udu3324/usb-mosaic_art/README.md

# usb-mosaic_art

A simple and fun gadget pcb
