udu3324/usb-mosaic_art/pcb/mosaic_usb/mosaic_usb.kicad_pcb

## KiCad design pcb/mosaic_usb/mosaic_usb.kicad_pcb (2026-08-22)

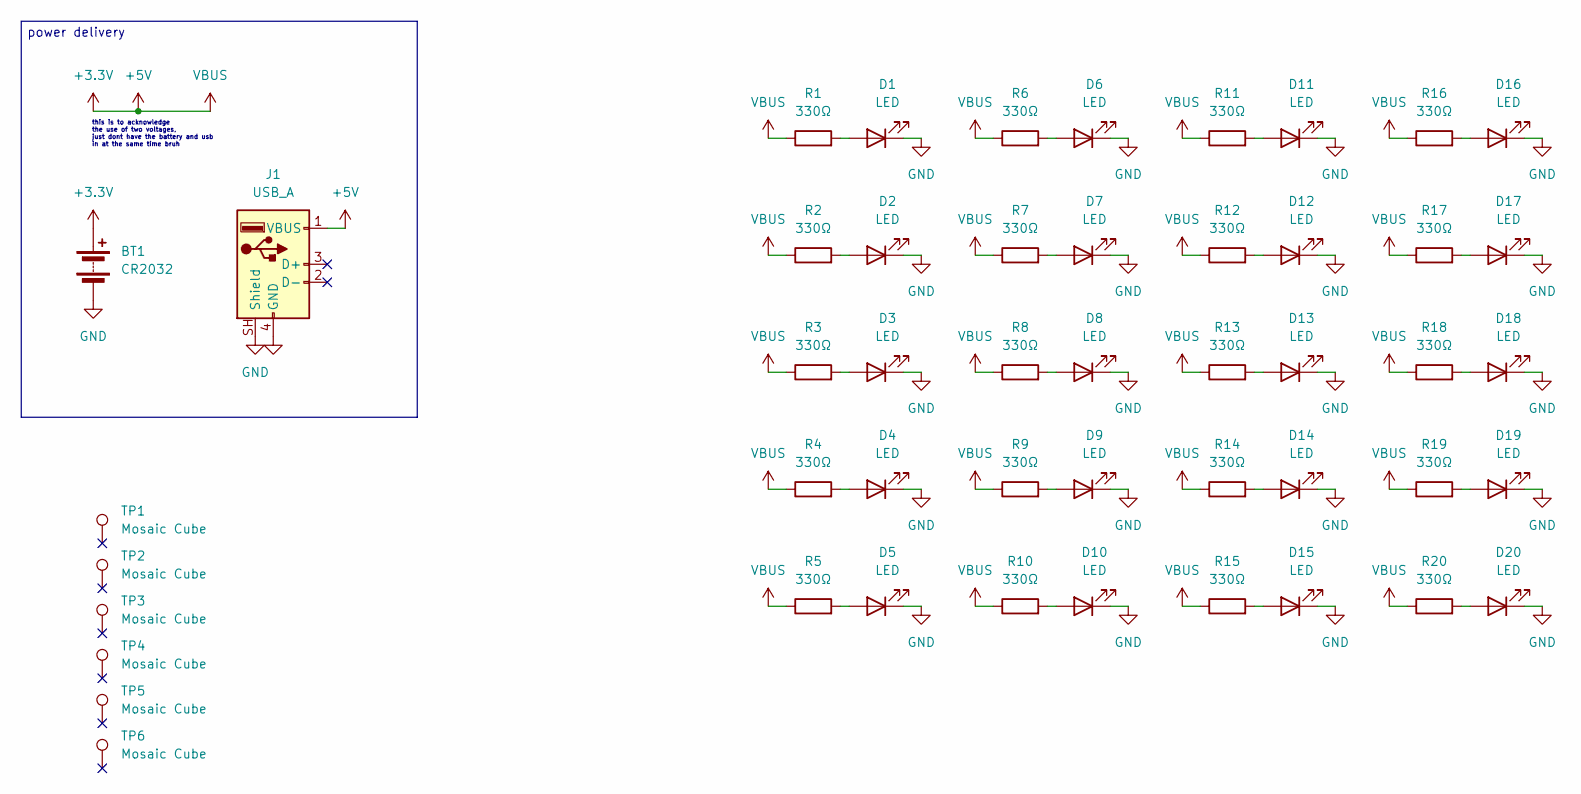
[picture p1: schematic mosaic_usb.kicad_sch]

Parts:
BT1: CR2032; BATT_HLDR_LNX
D1, D2, D3, D4, D5, D6, D7, D8, D9, D10, D11, D12, D13, D14, D15, D16, D17, D18, D19, D20: LED; LED_D3.0mm_Clear_Sideways_Hack
J1: USB_A; USB_A_PCB_Edge_receptacle
R1, R2, R3, R4, R5, R6, R7, R8, R9, R10, R11, R12, R13, R14, R15, R16, R17, R18, R19, R20: 330Ω; R_0603_1608Metric
TP1, TP2, TP3, TP4, TP5, TP6: Mosaic Cube; Mosaic Copper Cube

Connections:
+3.3V: BT1.1 (+), J1.1 (VBUS), R1.1, R2.1, R3.1, R4.1, R5.1, R6.1, R7.1, R8.1, R9.1, R10.1, R11.1, R12.1, R13.1, R14.1, R15.1, R16.1, R17.1, R18.1, R19.1, R20.1
GND: BT1.2 (-), D1.1 (K), D2.1 (K), D3.1 (K), D4.1 (K), D5.1 (K), D6.1 (K), D7.1 (K), D8.1 (K), D9.1 (K), D10.1 (K), D11.1 (K), D12.1 (K), D13.1 (K), D14.1 (K), D15.1 (K), D16.1 (K), D17.1 (K), D18.1 (K), D19.1 (K), D20.1 (K), J1.4 (GND), J1.SH (Shield)
unnamed: D1.2 (A), R1.2
unnamed: D2.2 (A), R2.2
unnamed: D3.2 (A), R3.2
unnamed: D4.2 (A), R4.2
unnamed: D5.2 (A), R5.2
unnamed: D6.2 (A), R6.2
unnamed: D7.2 (A), R7.2
unnamed: D8.2 (A), R8.2
unnamed: D9.2 (A), R9.2
unnamed: D10.2 (A), R10.2
unnamed: D11.2 (A), R11.2
unnamed: D12.2 (A), R12.2
unnamed: D13.2 (A), R13.2
unnamed: D14.2 (A), R14.2
unnamed: D15.2 (A), R15.2
unnamed: D16.2 (A), R16.2
unnamed: D17.2 (A), R17.2
unnamed: D18.2 (A), R18.2
unnamed: D19.2 (A), R19.2
unnamed: D20.2 (A), R20.2

Notes on the sheet:
this is to acknowledge the use of two voltages, just dont have the battery and usb in at the same time bruh
power delivery

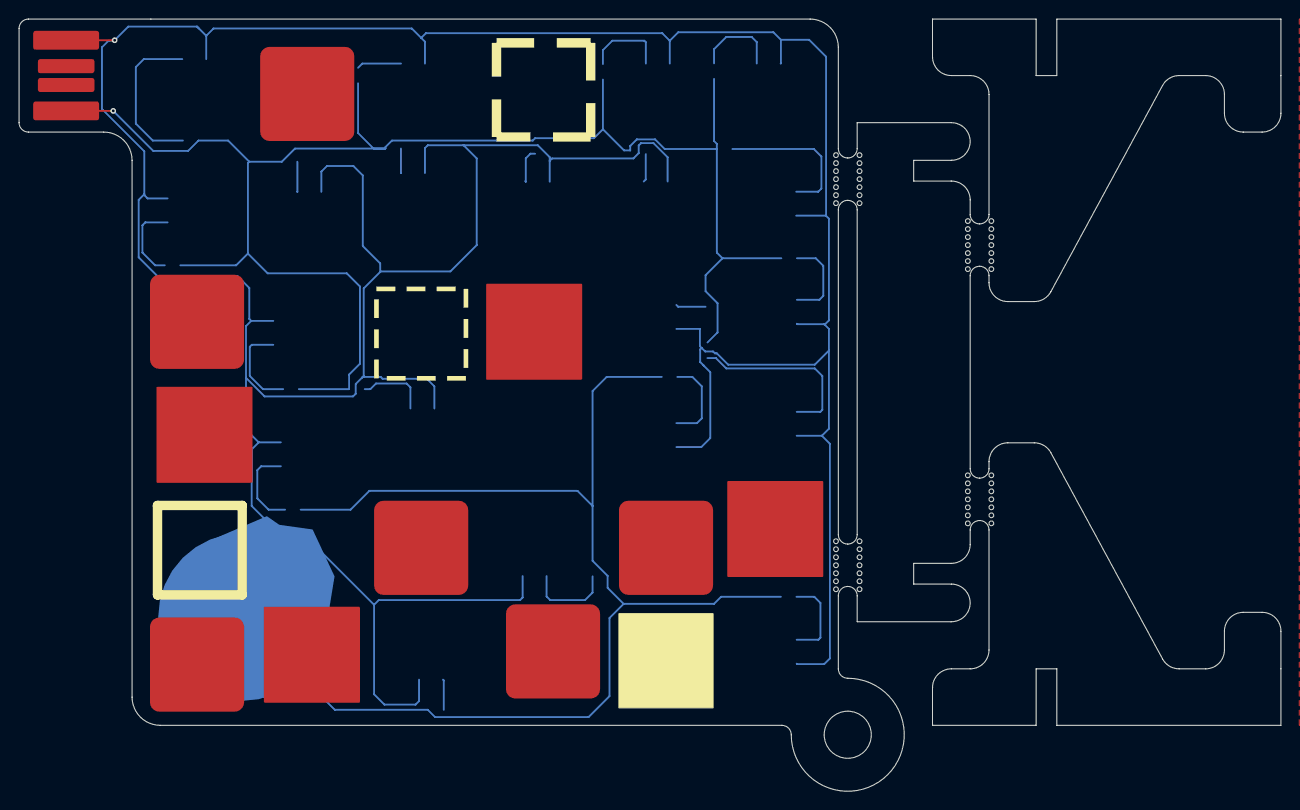
[picture p2: board mosaic_usb.kicad_pcb from above]

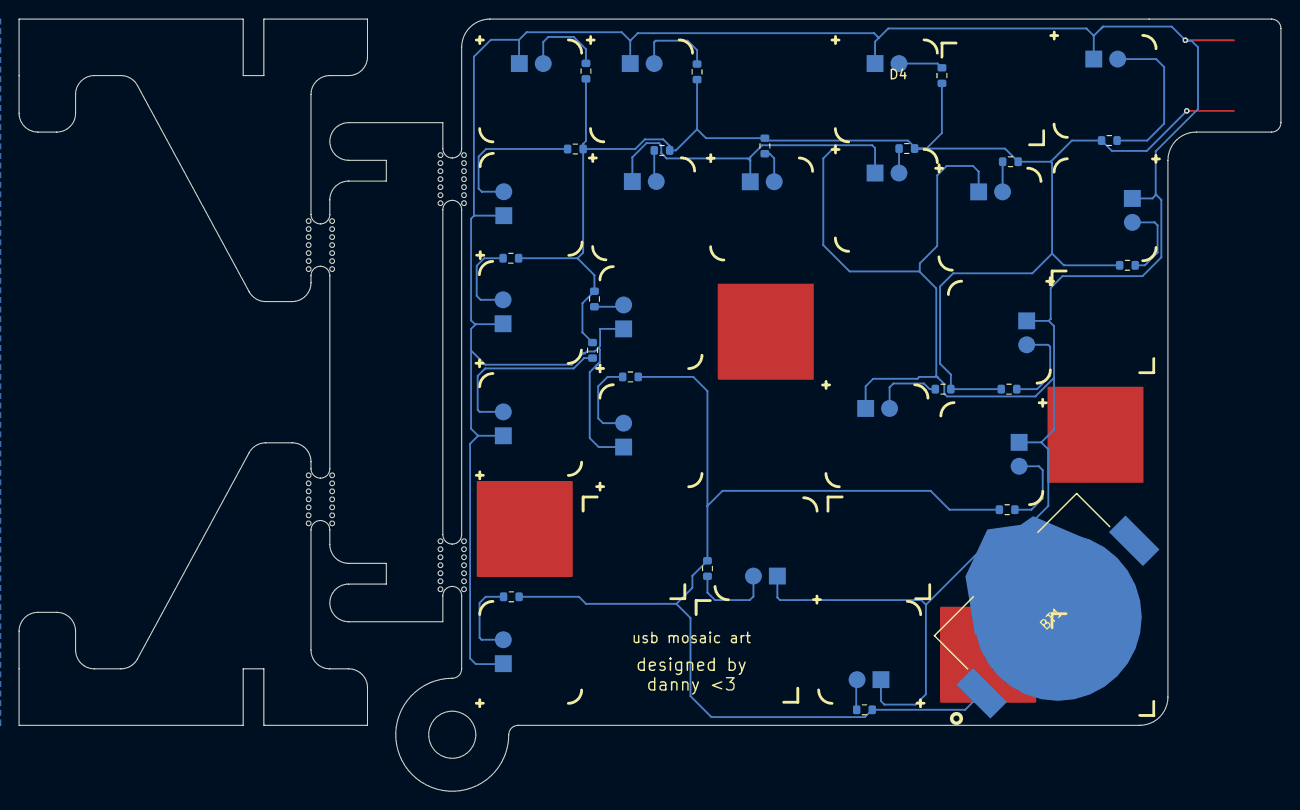
[picture p3: board mosaic_usb.kicad_pcb from below]

Board: 2 copper layers, 134.0 x 82.0 mm, 48 parts (41 on the bottom side), 22 nets.
