udu3324/usb-mosaic_art/JOURNAL.md

# Entry 1: The Sketch

8/12/2026 - 15-30 minutes (post git repo creation)

I started sketching out my project and what idea i had in mind.
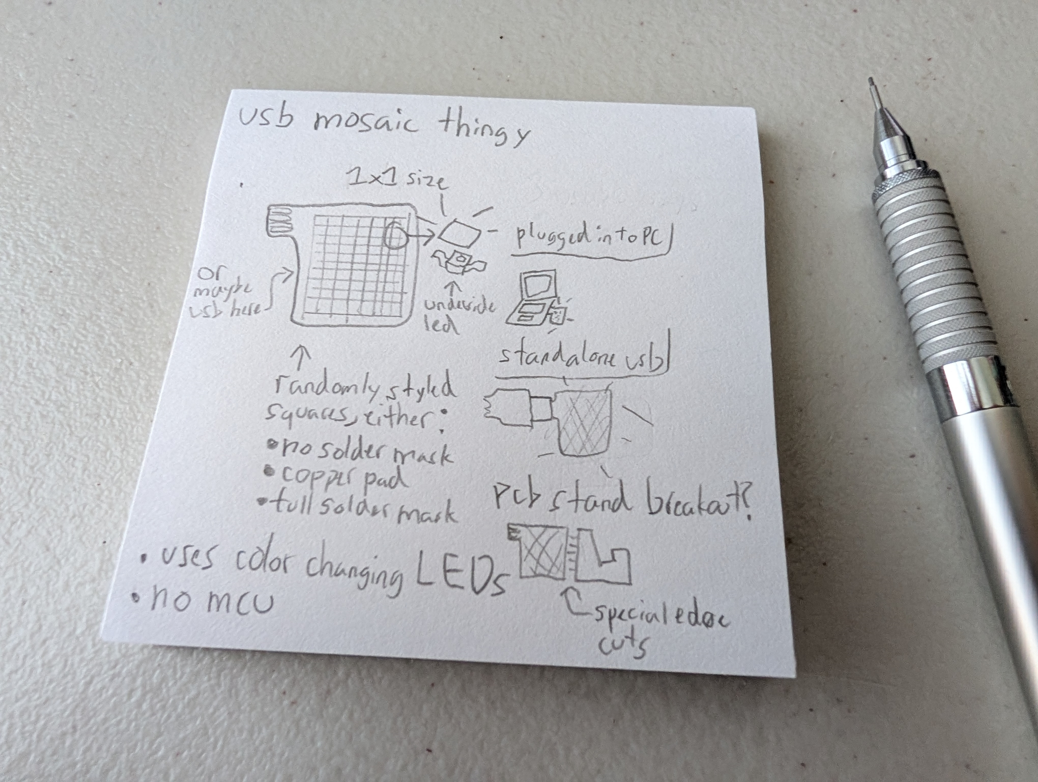
[picture p4: assets/sketch.jpg]
sketch


It was something that was
 * A simple usb 2.0 powered pcb
 * Light up glowing mosaic
 * Has no MCU
 * Strategic solder mask/copper placement
 * Maybe a cutout pcb stand footprint

# Entry 2: Part Identification and Starting Schematic

8/13/2026 - ~1.5 hours

At first, I thought it was going to be easy to find these underside leds, but the terms for them are a little unstandardized and took a while to find.

They are "Reverse Gullwing" LEDs that can shine under itself, but some [hackaday](https://hackaday.io/page/6081-using-side-view-leds-in-place-of-reverse-mount-leds) articles (traced from another [article](https://hackaday.com/2019/04/17/the-science-of-reverse-mounted-leds/)) say that they're unfortunately expensive. 

I have been looking through a bunch of LED options, including but not limited to
 * Reverse Gullwing LEDs that need a mcu
 * Side mount LEDs (can't find one that cycles through colors)
 * Flat LEDs that can be soldered the opposite way

At this point, I will take a compromise of these [tht LEDs](https://www.sparkfun.com/led-3mm-cycling-rgb-fast.html) that cycle colors and are really small. The previous hackaday article recommended hot glue on side mount leds to help spread into the pcb, but why not just use tht leds with hot glue anyways?

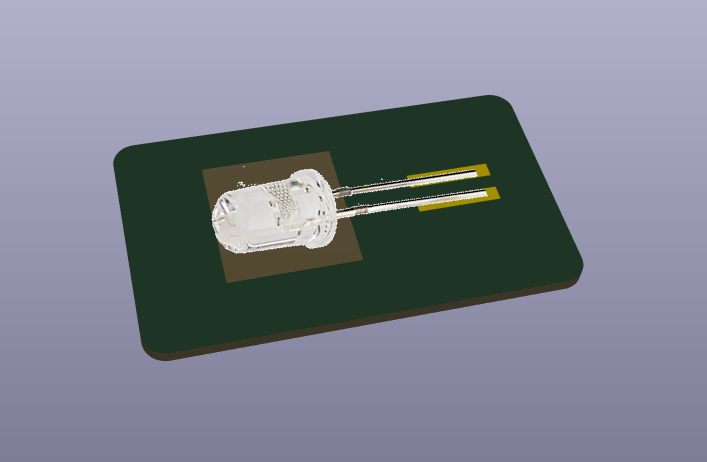
[picture p5: assets/concept1.png]
concept


# Entry 3: Actual Schematic Work + Calculations

8/14/2026 - 1hr 

I plan to make the pcb small ish, like the dimensions of a standard sticky/post note (71x71mm)

Each LED would take a 5.5mm square, excluding the legs which would make it 5.5x~8mm total for each cube that is lit up on my mosaic.

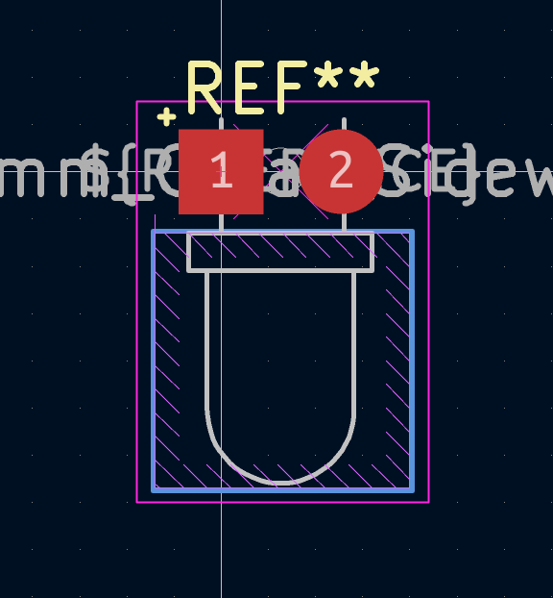
[picture p6: assets/ledfootprint.png]
ledfootprint


The mosaic itself would not actually be fully filled with LEDs, but have some randomness in different sections to help fit some extra components. 

PCB surface area: 5041 = 71^2

LED footprint: 44 = 5.5*8

Not allocating the entire board for leds: 5041/5 = 1008.2 surface area left

1008/44 = ~22 LEDs that I can fit into spots in my mosaic

# Entry 4: Polishing Footprint, Starting PCB Layout

8/15/2026 - 2hrs

After finishing the schematic, I started to make the actual layout of the board.

The 3d model for the led was kinda off, so I decided to export the step and make my own modifications to make it shorter and bent to the pcb. Also, turns out there isn't really a intuitive way to make a fill zone for f.mask to remove it, so I had to make a smd apeture and tweak its layers to go around this.

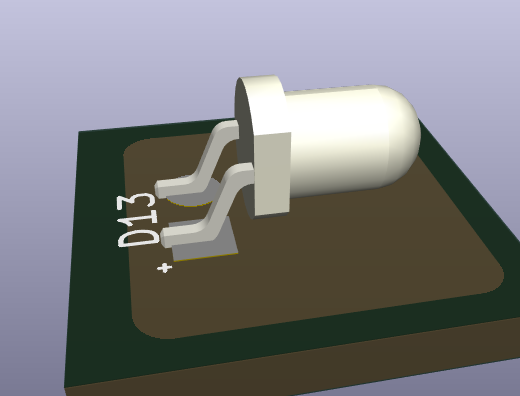
[picture p7: assets/thtsmdled.png]


So far I kind of solidified my idea of layout but definitely have not added all the neat copper or silkscreen pours yet. The usb footprint is also borrowed from a [kicad library](https://github.com/vasya-zh/PCB-Edge-USB-connector-KiCad-library/tree/main), but requires the pcb to be 2.0mm thick. 

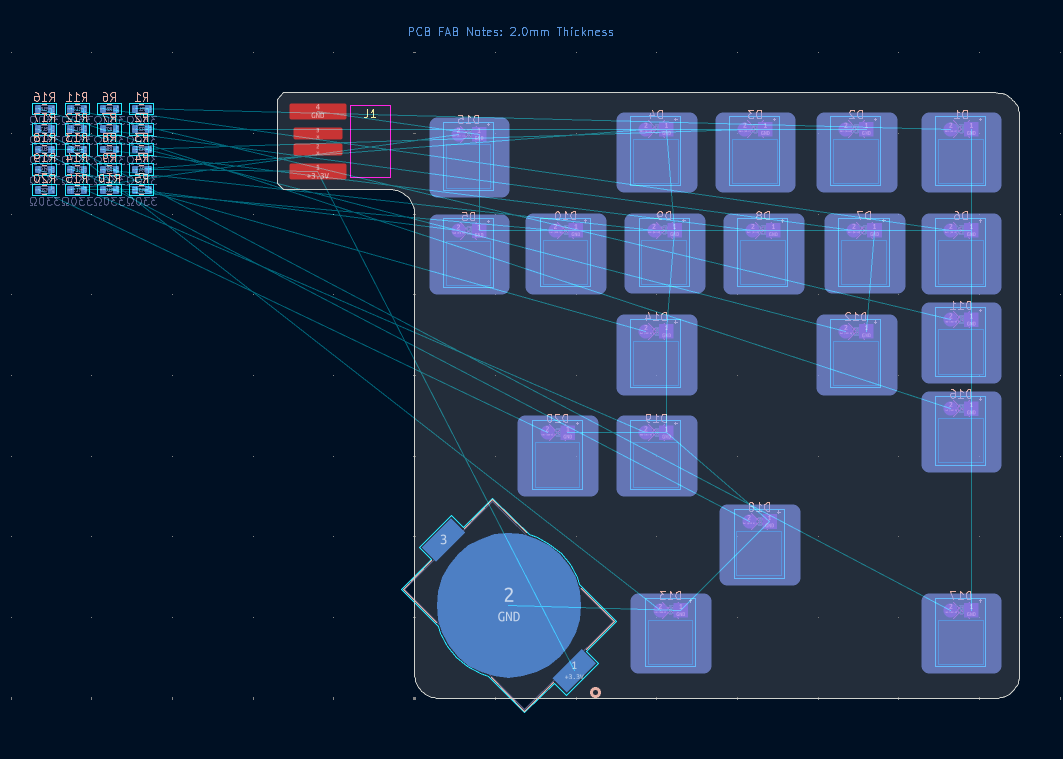
[picture p8: assets/pcbeditor.png]


# Entry 5: Continuing PCB Layout

8/16/2026 - 1hr

I continued to work on my mosaic and what it would look like. Another footprint with a pad had to be made as the PCB editor doesn't allow them to be added individually.

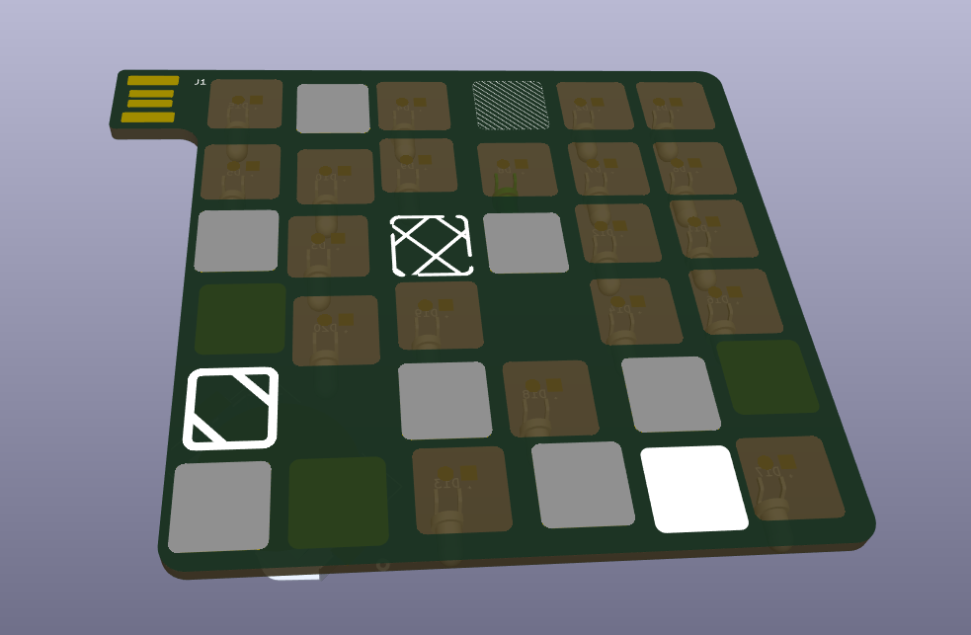
[picture p9: assets/pcbpreview.png]


The three part pcb cutout was sketched out and will be put somewhere around the main pcb on mouse bites. 
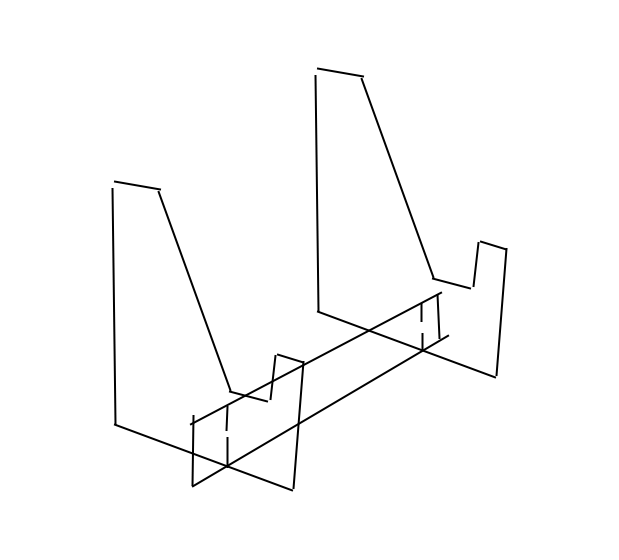
[picture p10: assets/standsketch.png]


# Entry 6: Adding a PCB Stand Cutout

8/17/2026 - 1hr

To hold up the main mosaic pcb, I prototyped a stand made of paper and took some measurements for my edge cuts.

Making sure to adhere to pcb fabrication tolerances, most list that they have a +-20-10% tolerance which equals to around 0.2mm of space needed. 

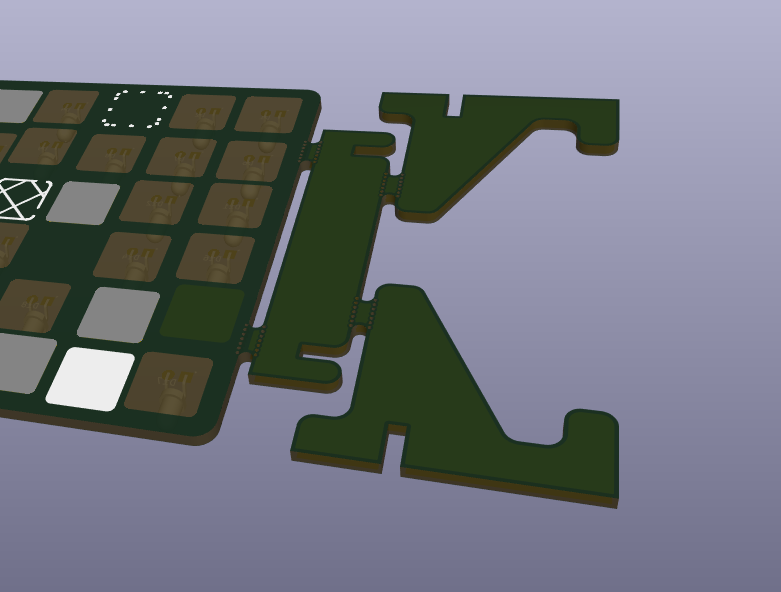
[picture p11: assets/stand-cutout.png]


# Entry 7: Placing and Routing

8/19/2026 - 3hr

It took quite a while to first decide where the resistors would go. It had to not collide with other mosaic squares, silkscreen, and the clear f.mask. 

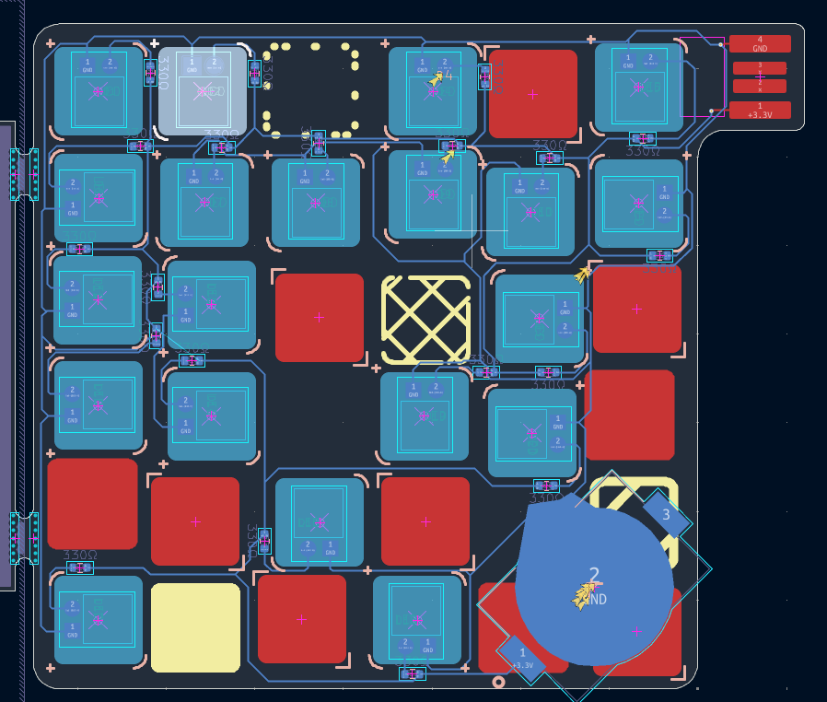
[picture p12: assets/routing.png]
routing


Routing was also difficult as there was no ground pour at all. Space was pretty limited but it worked out well. 

# Entry 8: Additions + Polishing

8/21/2026 - 1 hr

I added a hole extending out of my pcb to allow hooking onto keychains etc. At first i was planning to add it around the usb cutout, but that would block plugging the usb 😅

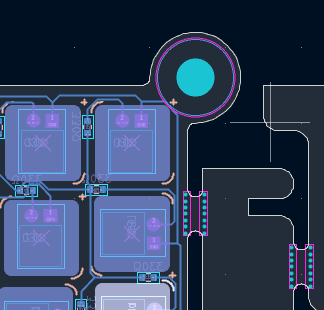
[picture p13: assets/holecutout.png]


Kicad's DRC checker was also ran a few times to check for any errors in routing. Some popped up but were all resolved! I hope that this board doesn't radiate much rf though as there's no solid ground plane. 

I contacted JLCPCB support and they unfortunately said no copper can be put on the standout part as they'll count it as more than one design. I decided to leave it blank or risk having bunch of pcb fees
