udu3324/usb-mosaic_art/(commit log)

2026-08-14 kicad + journal
    [mosaic_usb.kicad_pcb, mosaic_usb.kicad_sch]
2026-08-15 footprint and notes
    [mosaic_usb.kicad_pcb, mosaic_usb.kicad_sch]
2026-08-16 pcb layout
    [mosaic_usb.kicad_pcb, mosaic_usb.kicad_sch]
2026-08-17 pcb footprint
    [mosaic_usb.kicad_pcb, mosaic_usb.kicad_sch]
2026-08-18 add pcb stand
    [mosaic_usb.kicad_pcb]
2026-08-20 routing and placement
    [mosaic_usb.kicad_pcb]
2026-08-22 polish pcb
    [bom.csv, designators.csv, mosaic_usb.kicad_pcb, mosaic_usb.kicad_sch, positions.csv]
2026-08-22 pcb2blender export
